ericyao2013/upsat-obc-hardware/obc_sch.pdf

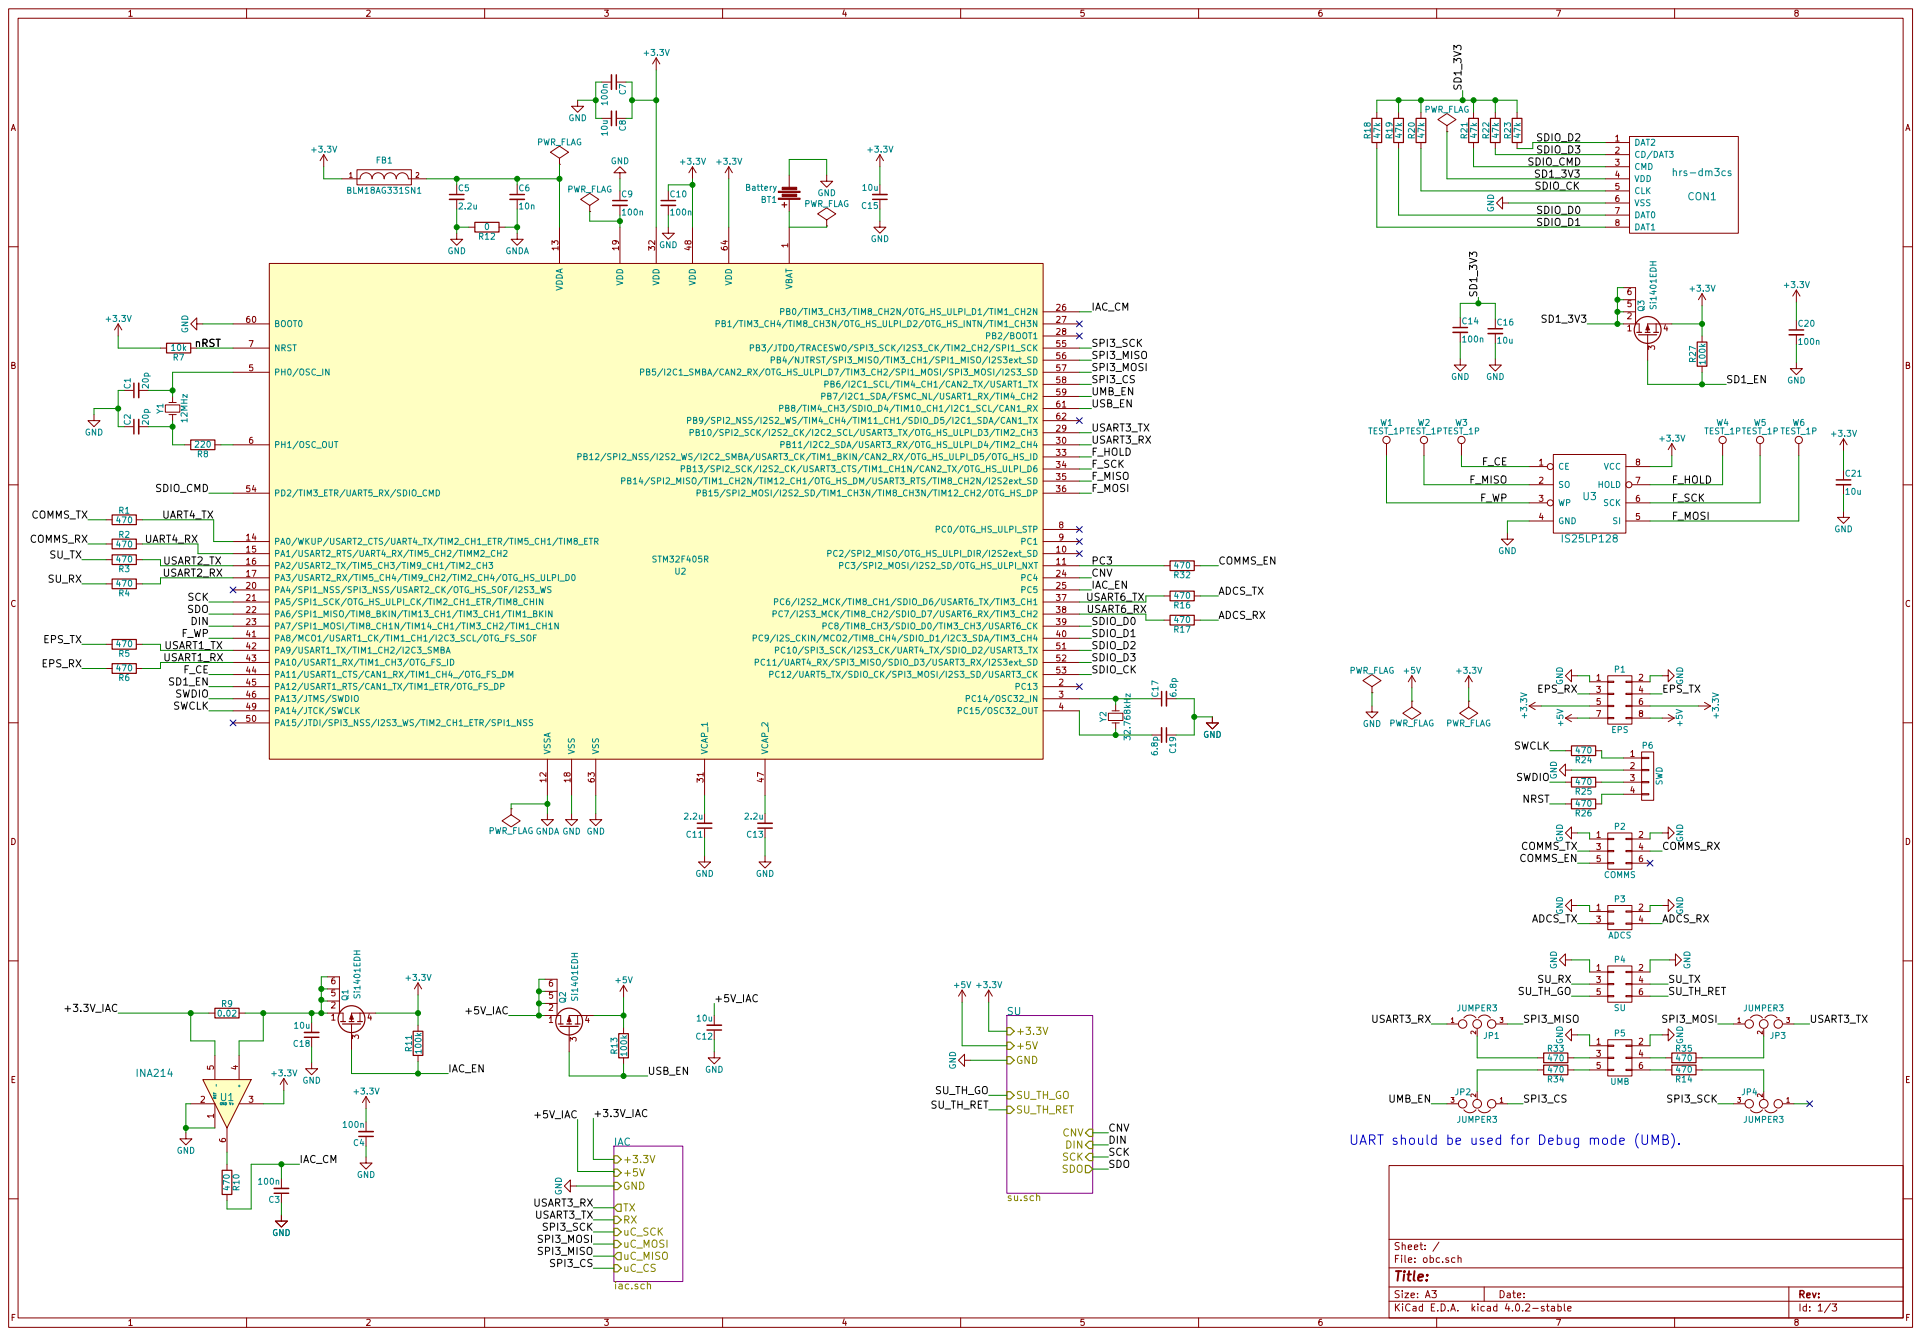
[picture p1: page 1]

PWR_FLAG UART should be used for Debug mode (UMB). C18

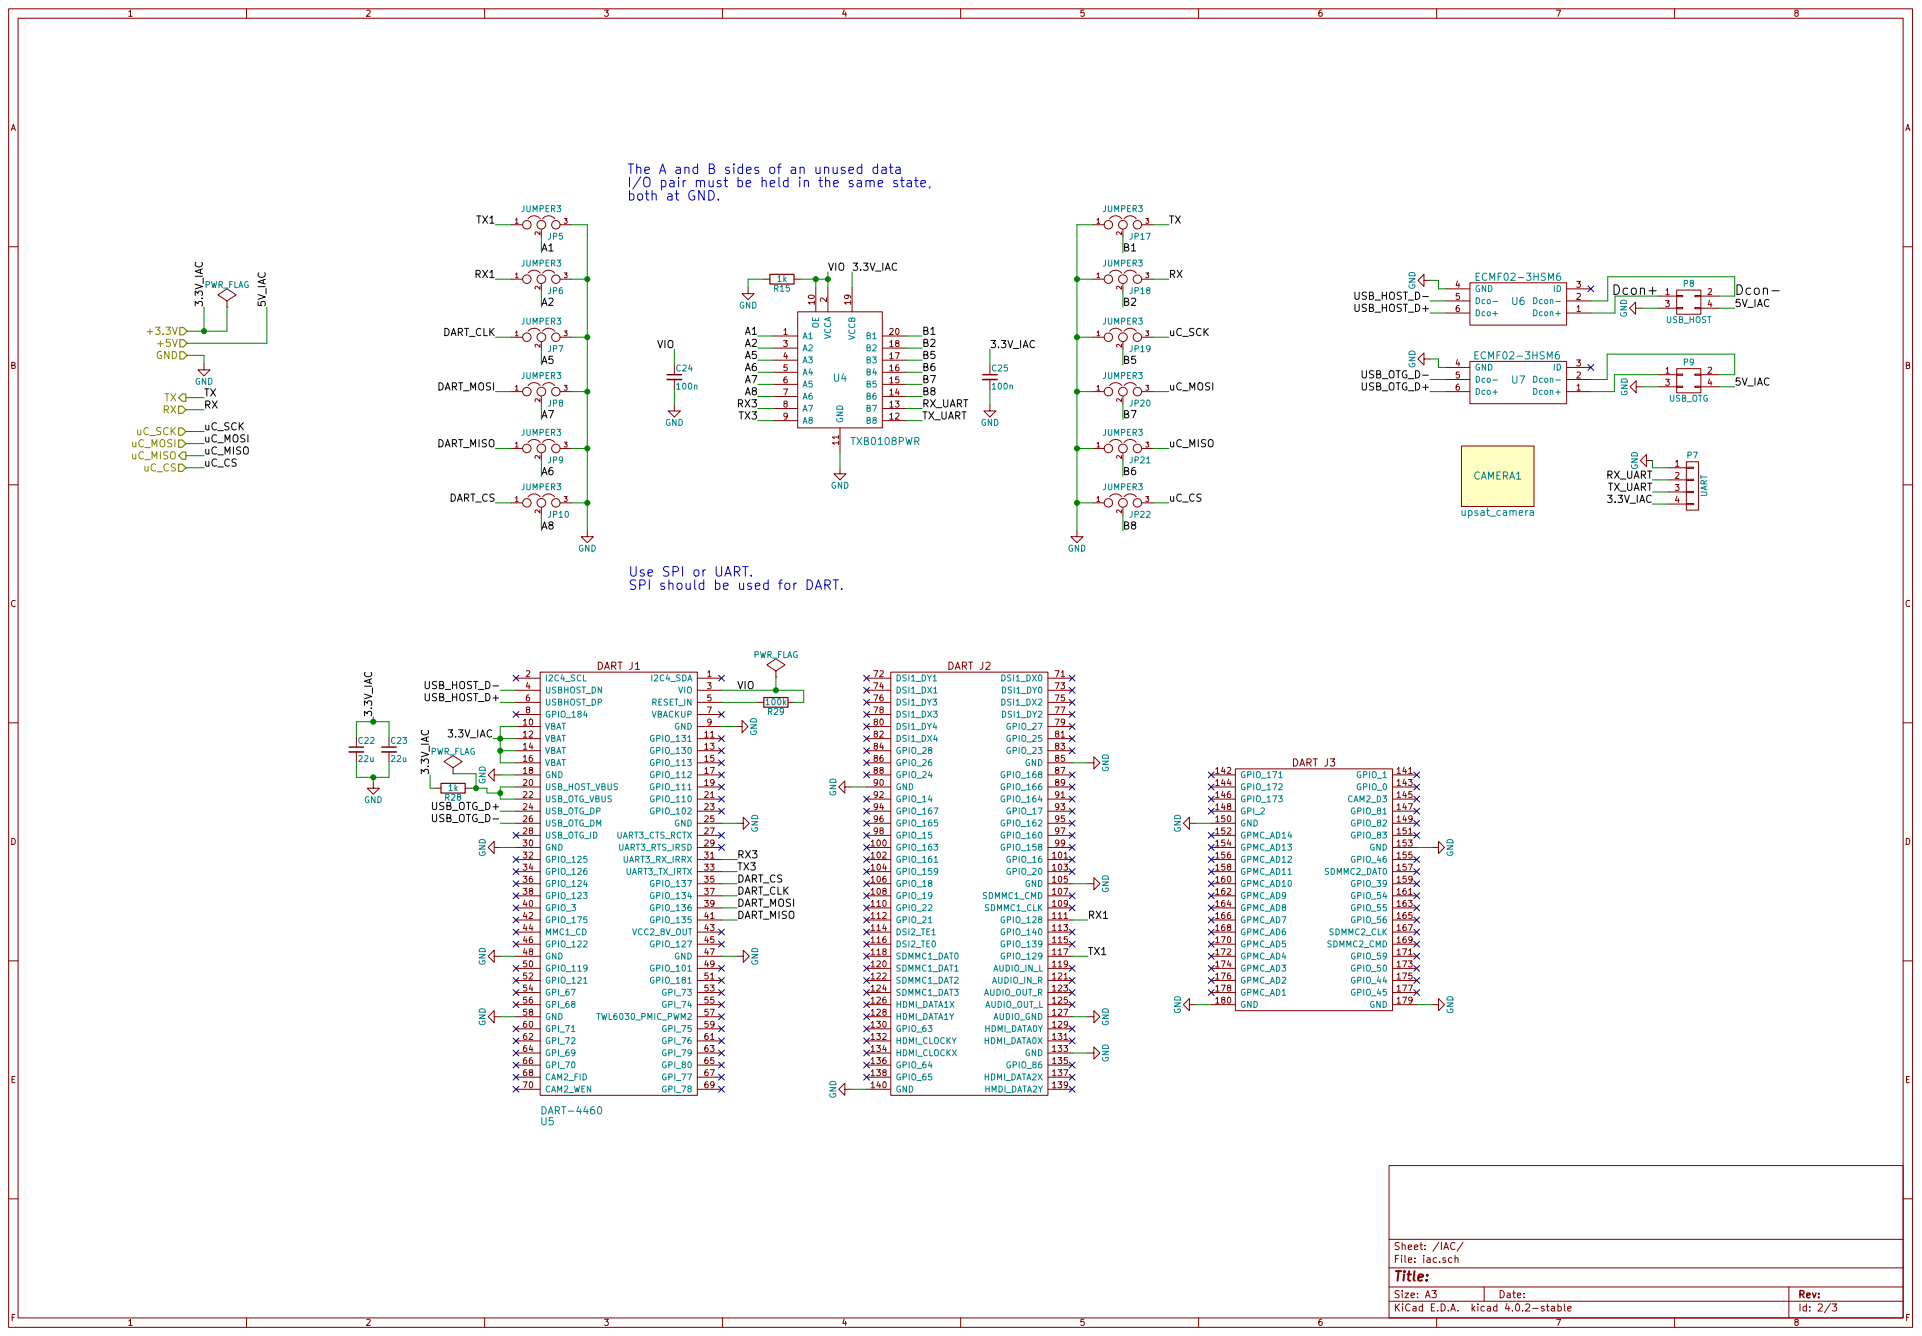
[picture p2: page 2]

The A and B sides of an unused data
I/O pair must be held in the same state,
both at GND.

Use SPI or UART.
SPI should be used for DART.

Id: 2/3 Title: File: iac.sch Sheet: /IAC/

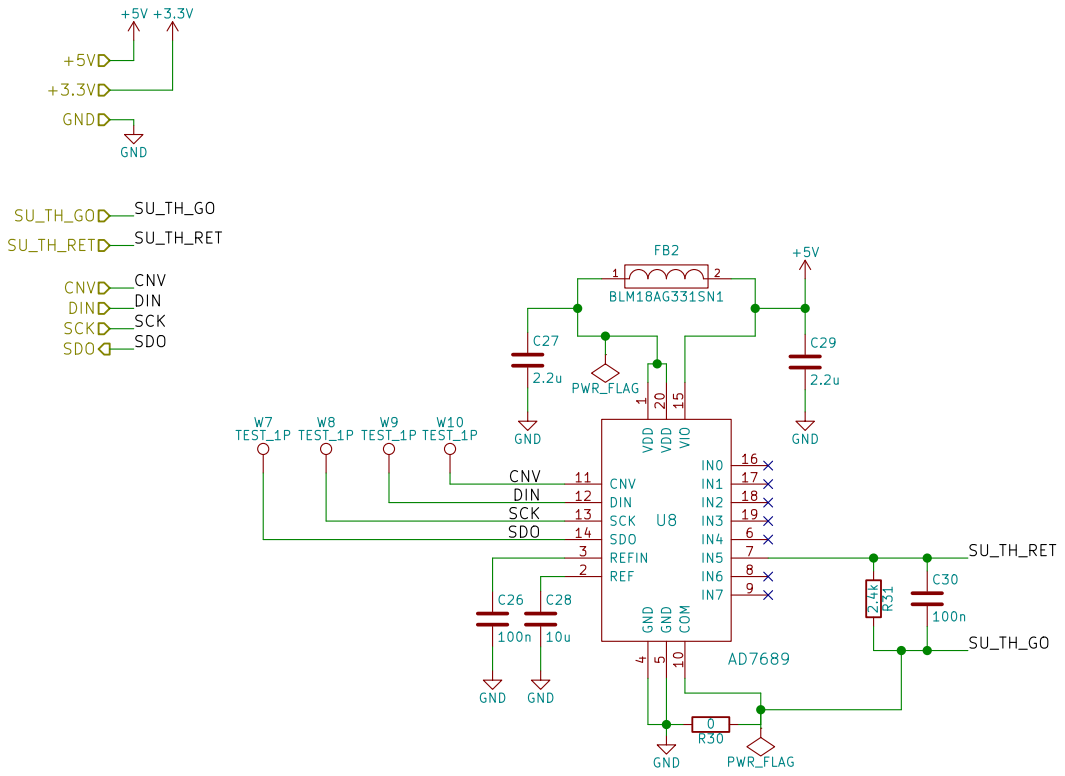
[picture p3: page 3]

Id: 3/3 Title: File: su.sch Sheet: /SU/
