ericyao2013/upsat-obc-hardware/cubeMX/obc_pinout.ioc

Mcu.UserName=STM32F405RGTx
PA0-WKUP.GPIO_Label=COMMS_TX_U4
PA0-WKUP.Signal=UART4_TX
PA1.GPIO_Label=COMMS_RX_U4
PA1.Signal=UART4_RX
PA10.GPIO_Label=EPS_RX_U1
PA10.Signal=USART1_RX
PA11.GPIO_Label=FLASH_CS_SPI2
PA11.Signal=GPIO_Output
PA12.GPIO_Label=SD_PWR_EN
PA12.Signal=GPIO_Output
PA13.Signal=SYS_JTMS-SWDIO
PA14.Signal=SYS_JTCK-SWCLK
PA2.GPIO_Label=SU_TX_U2
PA2.Signal=USART2_TX
PA3.GPIO_Label=SU_RX_U2
PA3.Signal=USART2_RX
PA5.GPIO_Label=ADC_SCK_SPI1
PA5.Signal=SPI1_SCK
PA6.GPIO_Label=ADC_MISO_SPI1
PA6.Signal=SPI1_MISO
PA7.GPIO_Label=ADC_MOSI_SPI1
PA7.Signal=SPI1_MOSI
PA8.GPIO_Label=FLASH_WP
PA8.Signal=GPIO_Output
PA9.GPIO_Label=EPS_TX_U1
PA9.Signal=USART1_TX
PB0.GPIO_Label=IAC_CM_ADC1_8
PB0.Signal=ADCx_IN8
PB10.GPIO_Label=DBG_TX_U3
PB10.Signal=USART3_TX
PB11.GPIO_Label=DBG_RX_U3
PB11.Signal=USART3_RX
PB12.GPIO_Label=FLASH_HOLD
PB12.Signal=GPIO_Output
PB13.GPIO_Label=FLASH_SCK_SPI2
PB13.Signal=SPI2_SCK
PB14.GPIO_Label=FLASH_MISO_SPI2
PB14.Signal=SPI2_MISO
PB15.GPIO_Label=FLASH_MOSI_SPI2
PB15.Signal=SPI2_MOSI
PB3.GPIO_Label=IAC_SCK_SPI3
PB3.Signal=SPI3_SCK
PB4.GPIO_Label=IAC_MISO_SPI3
PB4.Signal=SPI3_MISO
PB5.GPIO_Label=IAC_MOSI_SPI3
PB5.Signal=SPI3_MOSI
PB6.GPIO_Label=IAC_CS_SPI3
PB6.Signal=GPIO_Output
PB7.GPIO_Label=DBG_EN
PB7.Signal=GPIO_Output
PB8.GPIO_Label=IAC_CAMERA_PWR
PB8.Signal=GPIO_Output
PC10.Signal=SDIO_D2
PC11.Signal=SDIO_D3
PC12.Signal=SDIO_CK
PC14-OSC32_IN.Signal=RCC_OSC32_IN
PC15-OSC32_OUT.Signal=RCC_OSC32_OUT
PC3.GPIO_Label=COMMS_EN
PC3.Signal=GPIO_Output
PC4.GPIO_Label=ADC_CS_SPI1
PC4.Signal=GPIO_Output
PC5.GPIO_Label=IAC_EN
PC5.Signal=GPIO_Output
PC6.GPIO_Label=ADCS_TX_U6
PC6.Signal=USART6_TX
PC7.GPIO_Label=ADCS_RX_U6
PC7.Signal=USART6_RX
PC8.Signal=SDIO_D0
PC9.Signal=SDIO_D1
PD2.Signal=SDIO_CMD
PH0-OSC_IN.Signal=RCC_OSC_IN
PH1-OSC_OUT.Signal=RCC_OSC_OUT
