ericyao2013/upsat-obc-hardware/(commit log)

2016-02-06 Spin Torquer Firmware, Initial commit
    [stm32f0discoveryRESETNONE.cfg, stm32f4discoveryRESETNONE.cfg]
2016-02-15 Add pcb board for obc and library.
    [obc.kicad_pcb, obc.sch]
2016-02-16 Add pdf of obc schematic.
2016-03-27 Update obc schematic, PCB and add cubeMX config.
    [iac.sch, obc.kicad_pcb, obc.sch, su.sch]
2016-03-27 Update obc schematic pdf file.
2016-03-31 Update the obc schematic and pcb, WIP.
    [iac.sch, obc.kicad_pcb, obc.sch, su.sch]
2016-04-03 [WIP] Add-update obc_upsat lib and update sch-pcb. For 3-way_bridge_0603.kicad_mod, thanks to http://smisioto.no-ip.org/elettronica/kicad/kicad-en.htm
    [iac.sch, obc.kicad_pcb, obc.sch, su.sch]
2016-04-04 Finalize functionality, pending review.
    [iac.sch, obc.kicad_pcb, obc.sch]
2016-04-04 Change solder mask clearance.
    [obc.kicad_pcb]
2016-04-04 Add silkscreen in pcb.
    [obc.kicad_pcb]
2016-04-04 Add logo and route beautification.
    [obc.kicad_pcb]
2016-04-04 Fixes in schematic-pcb. Add 10uC capacitor after mosfet switches. Move r-c filter of current ADC near to micro controller.
    [obc.kicad_pcb, obc.sch]
2016-04-10 Update in obc board.
    Change package of IS25LP128.
    Add obc BOM.
    Update cubeMX pin-out.
    Change pin-out of iac_cm and iac_en in stm32f405.
    [iac.sch, obc.csv, obc.kicad_pcb, obc.sch, su.sch]
2016-04-10 Change holes of upsat_camera.kicad_mod to 3.2mm.
    [obc.kicad_pcb]
2016-04-23 Fixes in schematic and PCB.
    Resolve wrong power connection in sd-card.
    Place the camera in the bottom layer.
    Small fixes in routing.
    Update pdf schematic.
    [obc.kicad_pcb, obc.sch]
2016-05-05 Fixes in PCB and schematics.
    Change the layer of Dart components.
    Update routing of both layers.
    VBackup no connected in Dart.
    Change the pins (RX-TX) in the debug header of Dart.
    [iac.sch, obc.kicad_pcb]
2016-05-29 Small fixes in RX/TX and delete unused files.
    [iac.sch, obc.kicad_pcb, obc.sch, stm32f0discoveryRESETNONE.cfg, stm32f4discoveryRESETNONE.cfg]
