ericyao2013/upsat-obc-hardware/(notices)

Notices in the files:
obc.kicad_pcb:
Libre Space Foundation © 2016
